rheingoldheavy/arduino_uno_r3_from_scratch/(threads)

Thread 2 (2018-07-18):

KiCad library remap

hildogjr, 2018-07-18:
Is not possible to open the project and when opened doesn't recognize the libraries. This problem is caused by KiCad library migration.
Check discussion on https://forum.kicad.info/t/important-symbol-library-table-merged-into-development-branch/8447/17 that help to make a manual migration, if necessary.

Thread 4 (2023-01-27):

RESET circuit is wrong

DeepCoreSystem, 2023-01-27:
The RESET circuit on your schematic is wrong when compared to the Atmel AppNote AVR042. In normal operation, you have 5V - 0.7V = 4.3V at the RESET pin, but it doesn't provide any over-voltage protection. And when pushing the reset switch, you will have a short circuit to ground from 5V_LDO through D7 and the switch, without any resistance.
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

This picture below is copied directly from the AppNote AVR042 - AVR Hardware Design Considerations
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

sabogalc, 2024-04-29:
This was also mentioned in PR #1
