rheingoldheavy/arduino_uno_r3_from_scratch/ATMEGA16U2.sch

## KiCad design ATMEGA16U2.sch (2021-08-06)

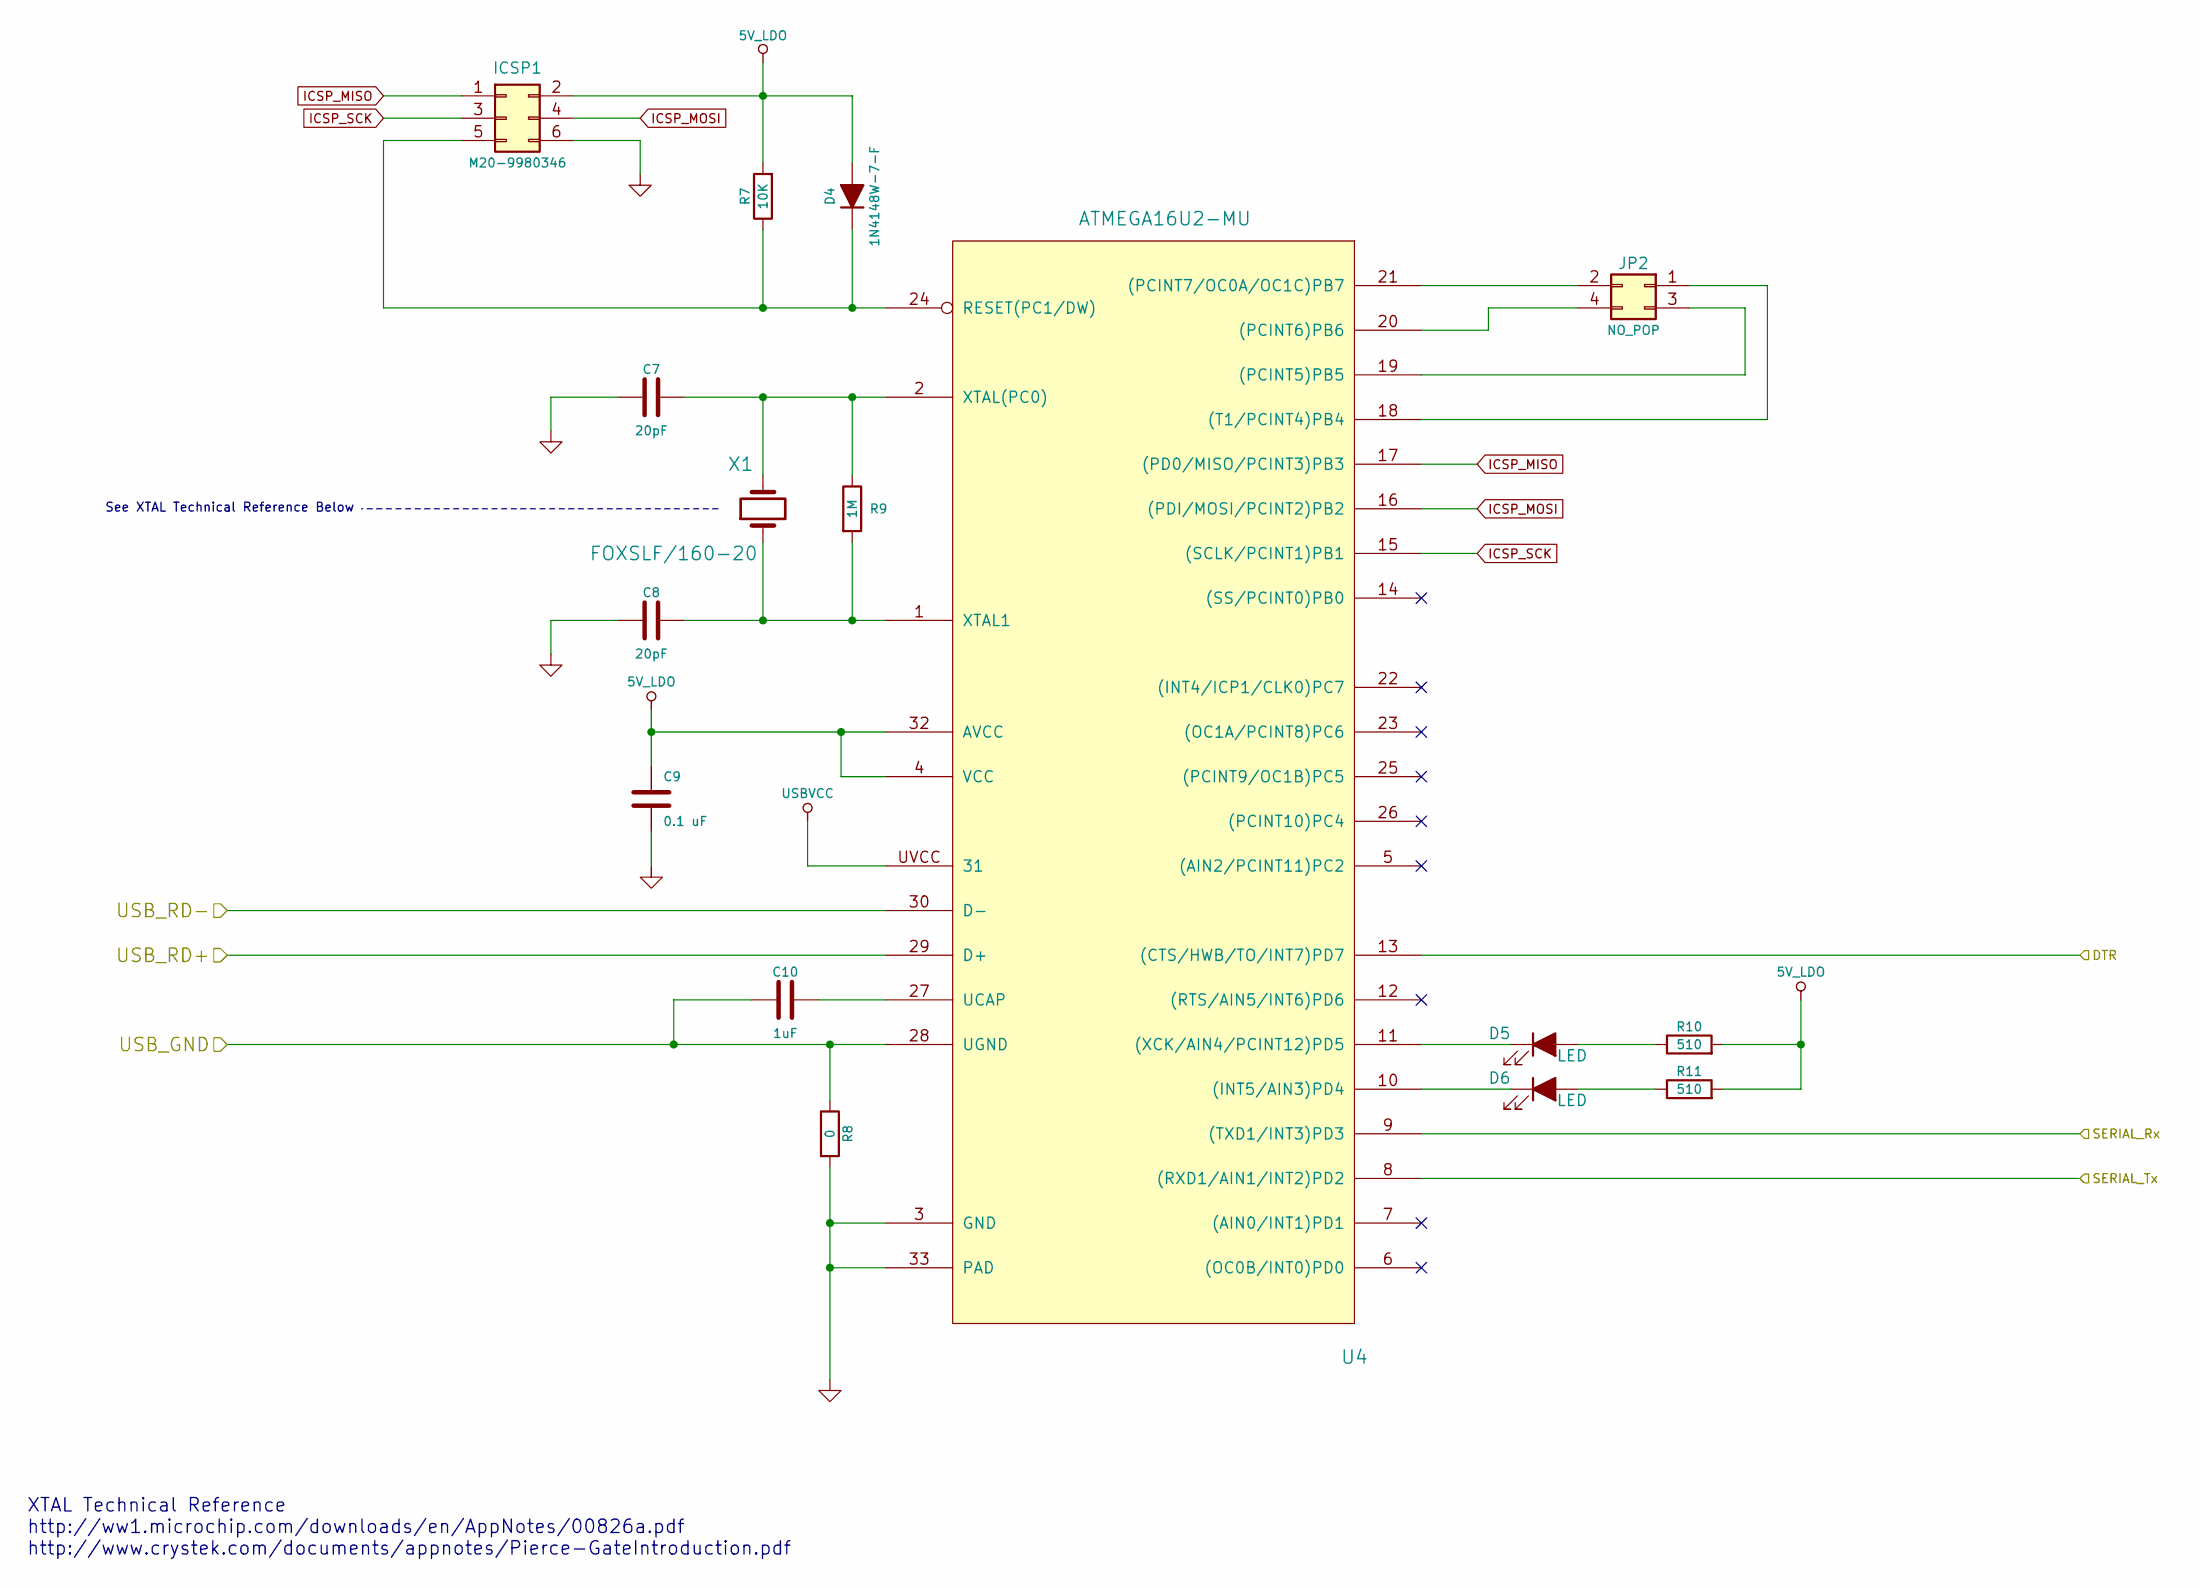
[picture p1: schematic ATMEGA16U2.sch]

Parts:
C7, C8: 20pF; MPN C0805C200G5GACTU
C9: 0.1 uF; MPN C0805C104K1RACAUTO
C10: 1uF; MPN C0805C105K8RACAUTO
D4: 1N4148W-7-F; MPN 1N4148W-7-F
D5, D6: LED; MPN LG R971-KN-1
ICSP1: M20-9980346; MPN M20-9980346
JP2: NO_POP; MPN FOOTPRINT ONLY
R7: 10K; MPN CRCW080510K0JNEA
R8: 0; MPN ERJ-6GEY0R00V
R9: 1M; MPN CRCW08051M00FKEA
R10, R11: 510; MPN RC0805FR-07510RL
U4: ATMEGA16U2-MU; MPN ATMEGA16U2-MU
X1: FOXSLF/160-20; MPN FOXSLF/160-20

Connections:
5V_LDO: C9.1, D4.2 (A), ICSP1.2, R7.2, R10.2, R11.2, U4.4 (VCC), U4.32 (AVCC)
DTR: U4.13 ((CTS/HWB/TO/INT7)PD7)
GND: C7.1, C8.1, C9.2, ICSP1.6, R8.2, U4.3 (GND), U4.33 (PAD)
ICSP_MISO: ICSP1.1, U4.17 ((PD0/MISO/PCINT3)PB3)
ICSP_MOSI: ICSP1.4, U4.16 ((PDI/MOSI/PCINT2)PB2)
ICSP_SCK: ICSP1.3, U4.15 ((SCLK/PCINT1)PB1)
unnamed: C7.2, R9.1, U4.2 (XTAL(PC0)), X1.2
unnamed: C8.2, R9.2, U4.1 (XTAL1), X1.1
unnamed: C10.2, U4.27 (UCAP)
unnamed: D4.1 (K), ICSP1.5, R7.1, U4.24 (RESET(PC1/DW))
unnamed: D5.1 (K), U4.11 ((XCK/AIN4/PCINT12)PD5)
unnamed: D5.2 (A), R10.1
unnamed: D6.1 (K), U4.10 ((INT5/AIN3)PD4)
unnamed: D6.2 (A), R11.1
unnamed: JP2.1, U4.18 ((T1/PCINT4)PB4)
unnamed: JP2.2, U4.21 ((PCINT7/OC0A/OC1C)PB7)
unnamed: JP2.3, U4.19 ((PCINT5)PB5)
unnamed: JP2.4, U4.20 ((PCINT6)PB6)
SERIAL_Rx: U4.9 ((TXD1/INT3)PD3)
SERIAL_Tx: U4.8 ((RXD1/AIN1/INT2)PD2)
USBVCC: U4.UVCC (31)
USB_GND: C10.1, R8.1, U4.28 (UGND)
USB_RD+: U4.29 (D+)
USB_RD-: U4.30 (D-)

Notes on the sheet:
XTAL Technical Reference http://ww1.microchip.com/downloads/en/AppNotes/00826a.pdf http://www.crystek.com/documents/appnotes/Pierce-GateIntroduction.pdf
See XTAL Technical Reference Below
