rheingoldheavy/arduino_uno_r3_from_scratch/ATMEGA328P.sch

## KiCad design ATMEGA328P.sch (2021-08-06)

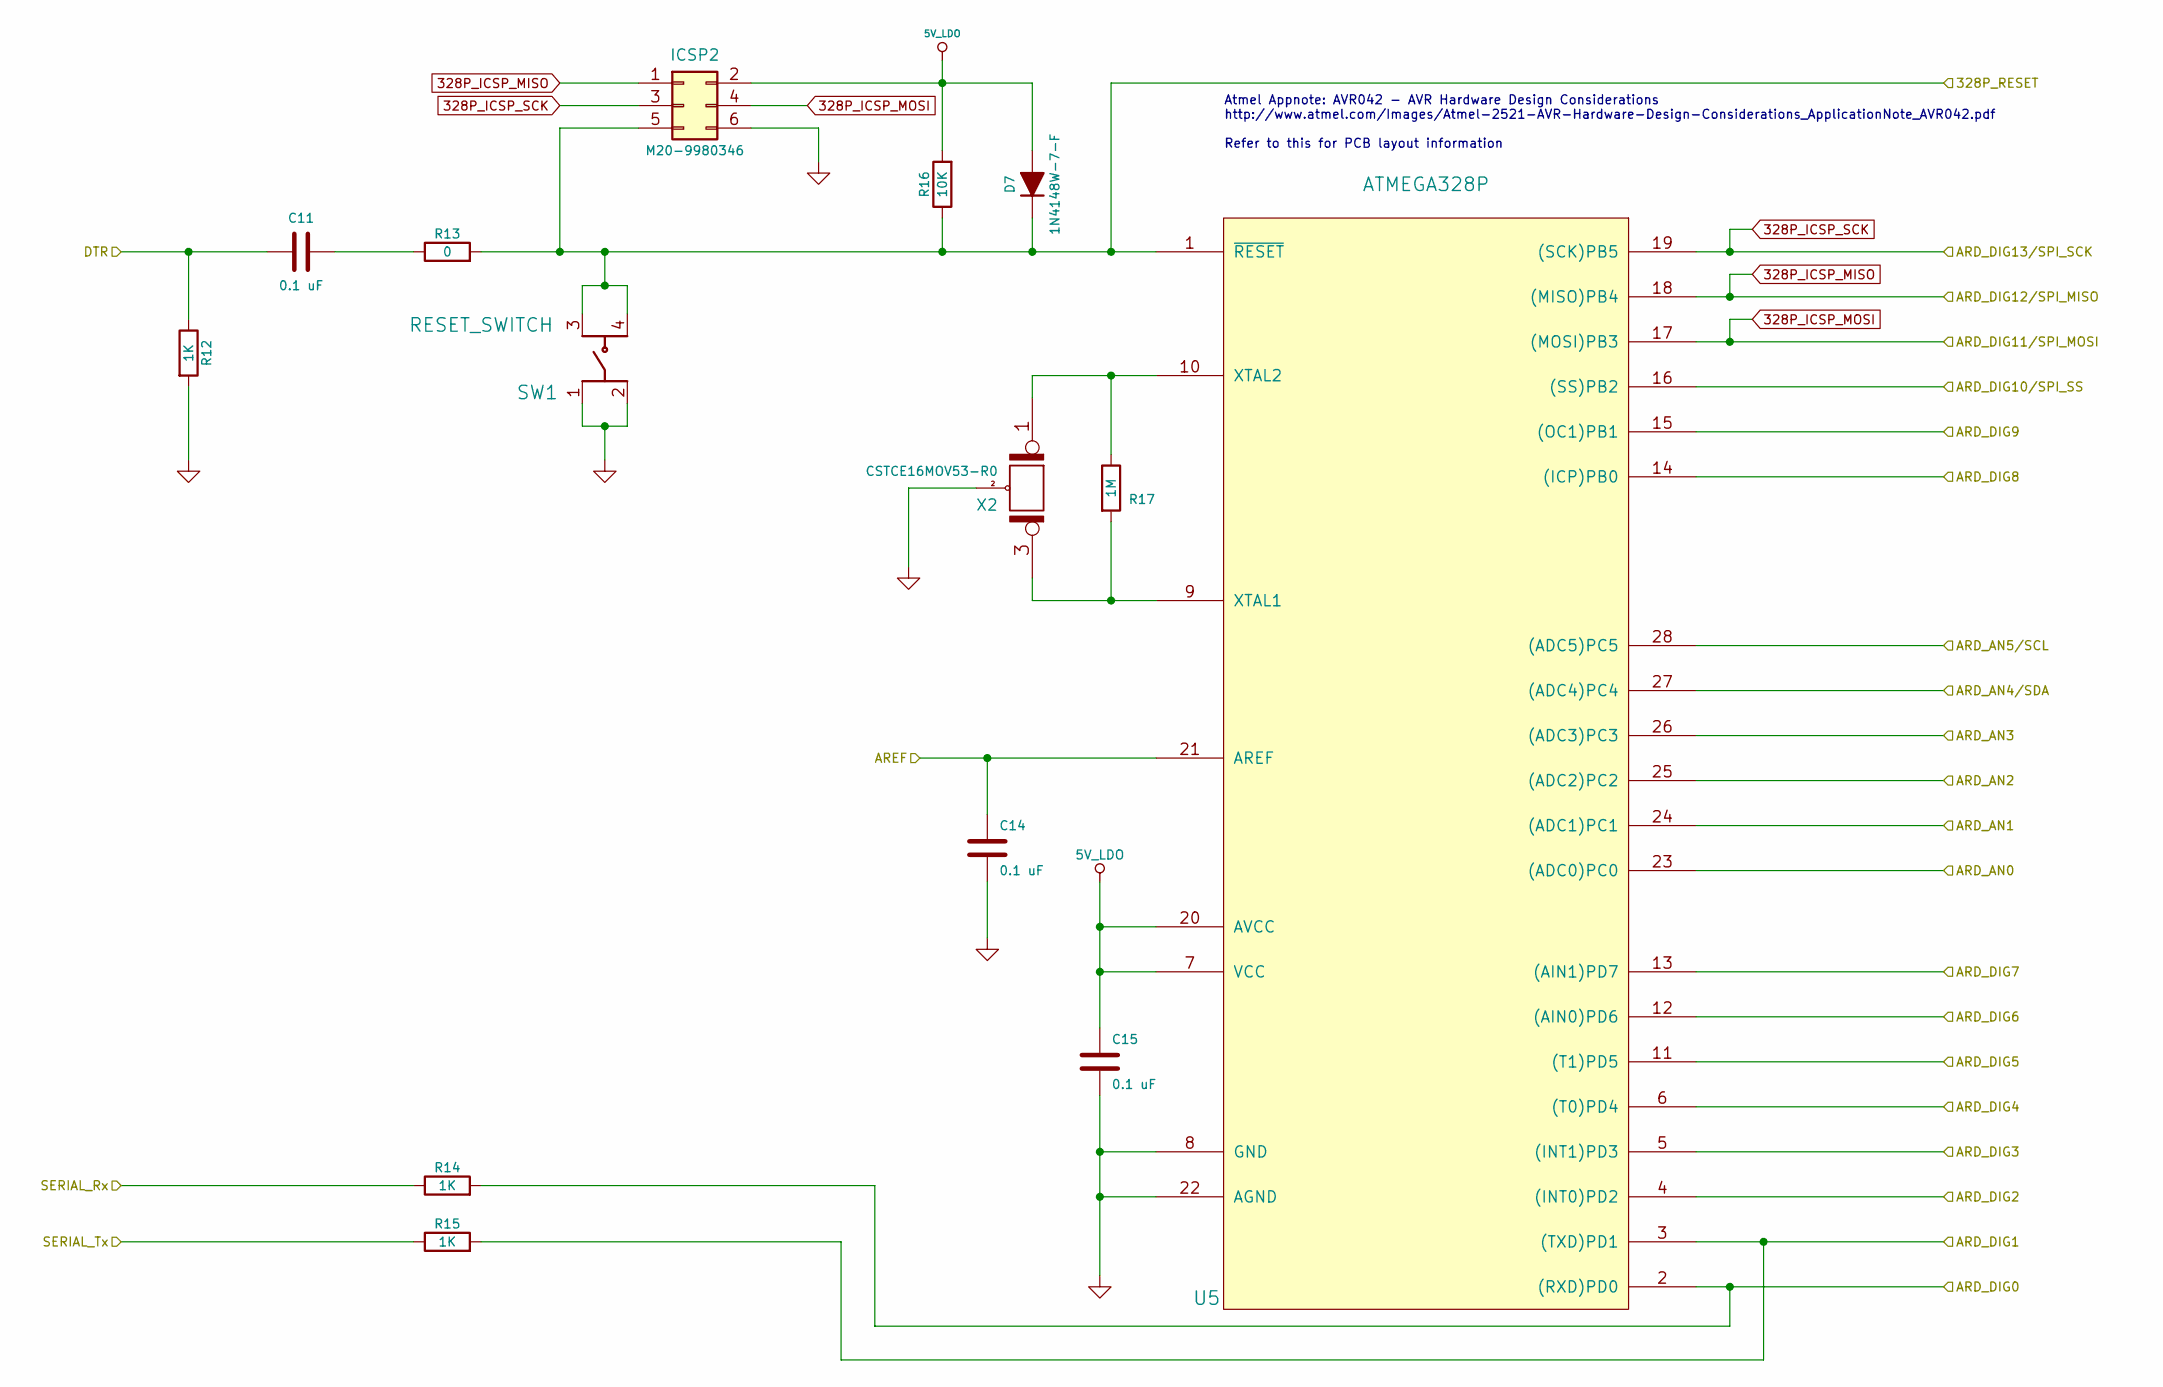
[picture p2: schematic ATMEGA328P.sch]

Parts:
C11, C14, C15: 0.1 uF; MPN C0805C104K1RACAUTO
D7: 1N4148W-7-F; MPN 1N4148W-7-F
ICSP2: M20-9980346; MPN M20-9980346
R12, R14, R15: 1K; MPN CRCW08051K00JNEA
R13: 0; MPN ERJ-6GEY0R00V
R16: 10K; MPN CRCW080510K0JNEA
R17: 1M; MPN CRCW08051M00FKEA
SW1: RESET_SWITCH; MPN EVQ-Q2U02W
U5: ATMEGA328P; MPN ATMEGA328P-PU
X2: CSTCE16MOV53-R0; MPN CSTCE16M0V53-R0

Connections:
5V_LDO: C15.1, D7.2 (A), ICSP2.2, R16.2, U5.7 (VCC), U5.20 (AVCC)
328P_ICSP_MISO: ICSP2.1, U5.18 ((MISO)PB4)
328P_ICSP_MOSI: ICSP2.4, U5.17 ((MOSI)PB3)
328P_ICSP_SCK: ICSP2.3, U5.19 ((SCK)PB5)
328P_RESET: D7.1 (K), ICSP2.5, R13.2, R16.1, SW1.3, SW1.4, U5.1 (~RESET)
ARD_AN0: U5.23 ((ADC0)PC0)
ARD_AN1: U5.24 ((ADC1)PC1)
ARD_AN2: U5.25 ((ADC2)PC2)
ARD_AN3: U5.26 ((ADC3)PC3)
ARD_AN4/SDA: U5.27 ((ADC4)PC4)
ARD_AN5/SCL: U5.28 ((ADC5)PC5)
ARD_DIG0: R14.2, U5.2 ((RXD)PD0)
ARD_DIG1: R15.2, U5.3 ((TXD)PD1)
ARD_DIG2: U5.4 ((INT0)PD2)
ARD_DIG3: U5.5 ((INT1)PD3)
ARD_DIG4: U5.6 ((T0)PD4)
ARD_DIG5: U5.11 ((T1)PD5)
ARD_DIG6: U5.12 ((AIN0)PD6)
ARD_DIG7: U5.13 ((AIN1)PD7)
ARD_DIG8: U5.14 ((ICP)PB0)
ARD_DIG9: U5.15 ((OC1)PB1)
ARD_DIG10/SPI_SS: U5.16 ((SS)PB2)
AREF: C14.1, U5.21 (AREF)
DTR: C11.1, R12.1
GND: C14.2, C15.2, ICSP2.6, R12.2, SW1.1, SW1.2, U5.8 (GND), U5.22 (AGND), X2.2 (PM)
unnamed: C11.2, R13.1
unnamed: R17.1, U5.10 (XTAL2), X2.1
unnamed: R17.2, U5.9 (XTAL1), X2.3
SERIAL_Rx: R14.1
SERIAL_Tx: R15.1

Notes on the sheet:
Atmel Appnote: AVR042 - AVR Hardware Design Considerations http://www.atmel.com/Images/Atmel-2521-AVR-Hardware-Design-Considerations_ApplicationNote_AVR042.pdf Refer to this for PCB layout information
