rheingoldheavy/arduino_uno_r3_from_scratch/Headers.sch

## KiCad design Headers.sch (2021-08-06)

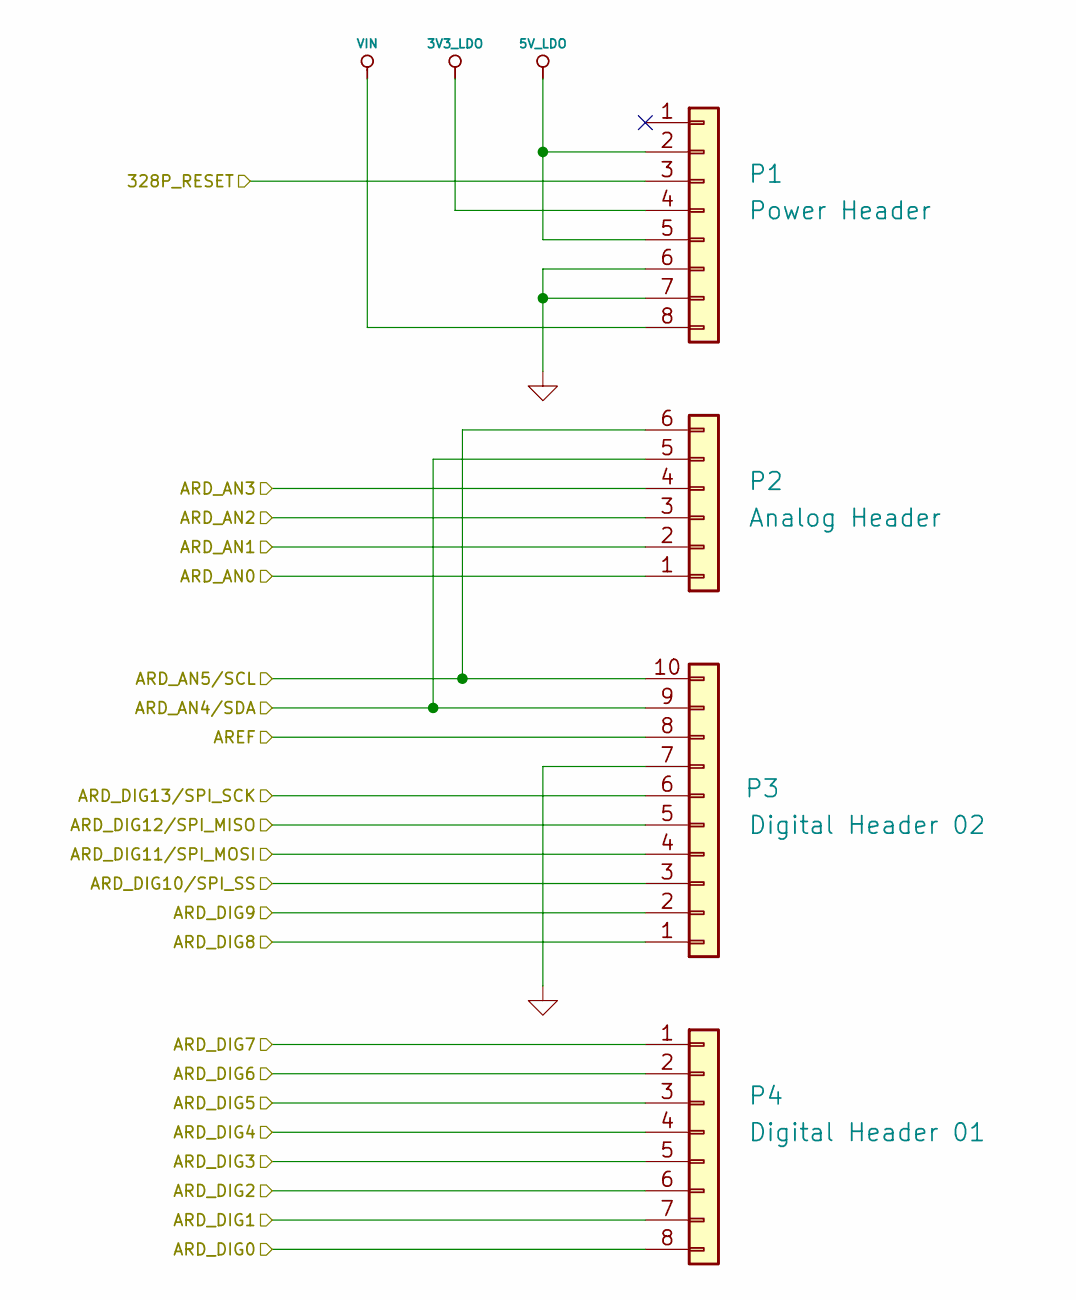
[picture p3: schematic Headers.sch]

Parts:
P1: Power Header; MPN NPPC081KFXC-RC
P2: Analog Header; MPN NPPC061KFXC-RC
P3: Digital Header 02; MPN NPPC101KFXC-RC
P4: Digital Header 01; MPN NPPC081KFXC-RC

Connections:
3V3_LDO: P1.4
5V_LDO: P1.2, P1.5
328P_RESET: P1.3
ARD_AN0: P2.1
ARD_AN1: P2.2
ARD_AN2: P2.3
ARD_AN3: P2.4
ARD_AN4/SDA: P2.5, P3.9
ARD_AN5/SCL: P2.6, P3.10
ARD_DIG0: P4.8
ARD_DIG1: P4.7
ARD_DIG2: P4.6
ARD_DIG3: P4.5
ARD_DIG4: P4.4
ARD_DIG5: P4.3
ARD_DIG6: P4.2
ARD_DIG7: P4.1
ARD_DIG8: P3.1
ARD_DIG9: P3.2
ARD_DIG10/SPI_SS: P3.3
ARD_DIG11/SPI_MOSI: P3.4
ARD_DIG12/SPI_MISO: P3.5
ARD_DIG13/SPI_SCK: P3.6
AREF: P3.8
GND: P1.6, P1.7, P3.7
VIN: P1.8
