rheingoldheavy/arduino_uno_r3_from_scratch/Pin_13_LED.sch

## KiCad design Pin_13_LED.sch (2021-08-06)

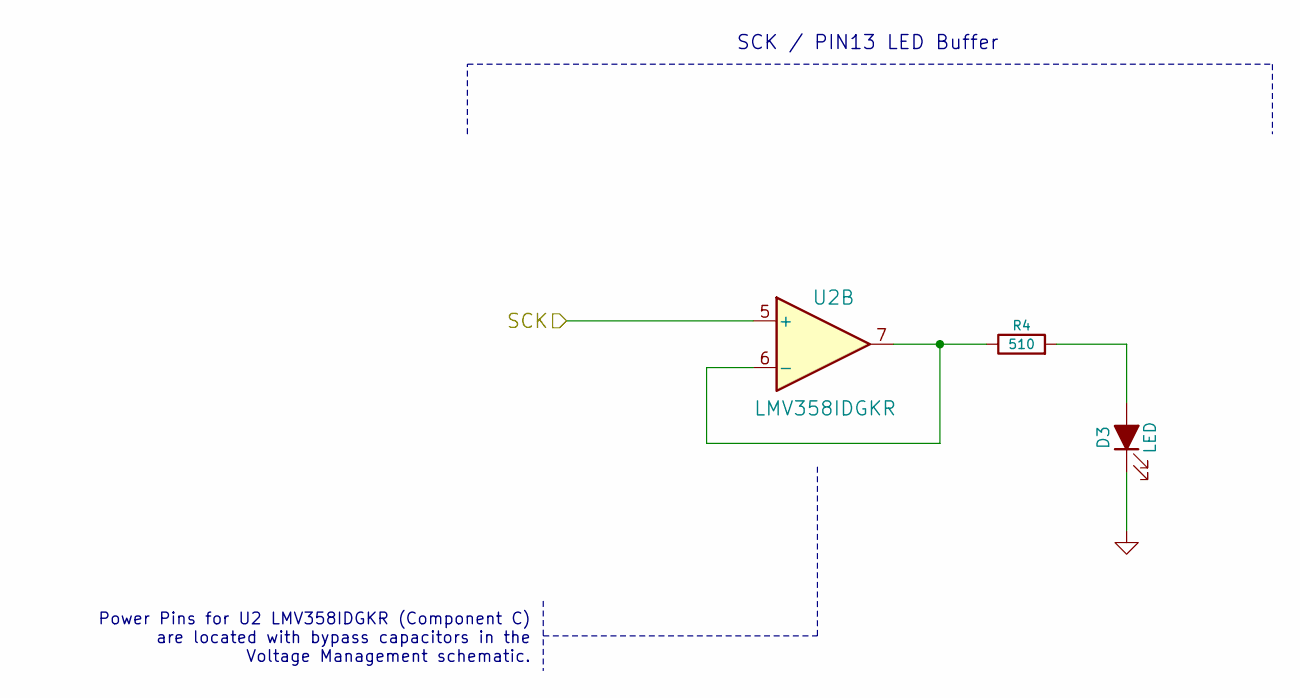
[picture p4: schematic Pin_13_LED.sch]

Parts:
D3: LED; MPN LG R971-KN-1
R4: 510; MPN RC0805FR-07510RL
U2: LMV358IDGKR; MPN LMV358IDGKR

Connections:
GND: D3.1 (K)
unnamed: D3.2 (A), R4.2
unnamed: R4.1, U2.6 (-), U2.7
SCK: U2.5 (+)

Notes on the sheet:
SCK / PIN13 LED Buffer
Power Pins for U2 LMV358IDGKR (Component C) are located with bypass capacitors in the Voltage Management schematic.
