rheingoldheavy/arduino_uno_r3_from_scratch/USB_Interface.sch

## KiCad design USB_Interface.sch (2021-08-06)

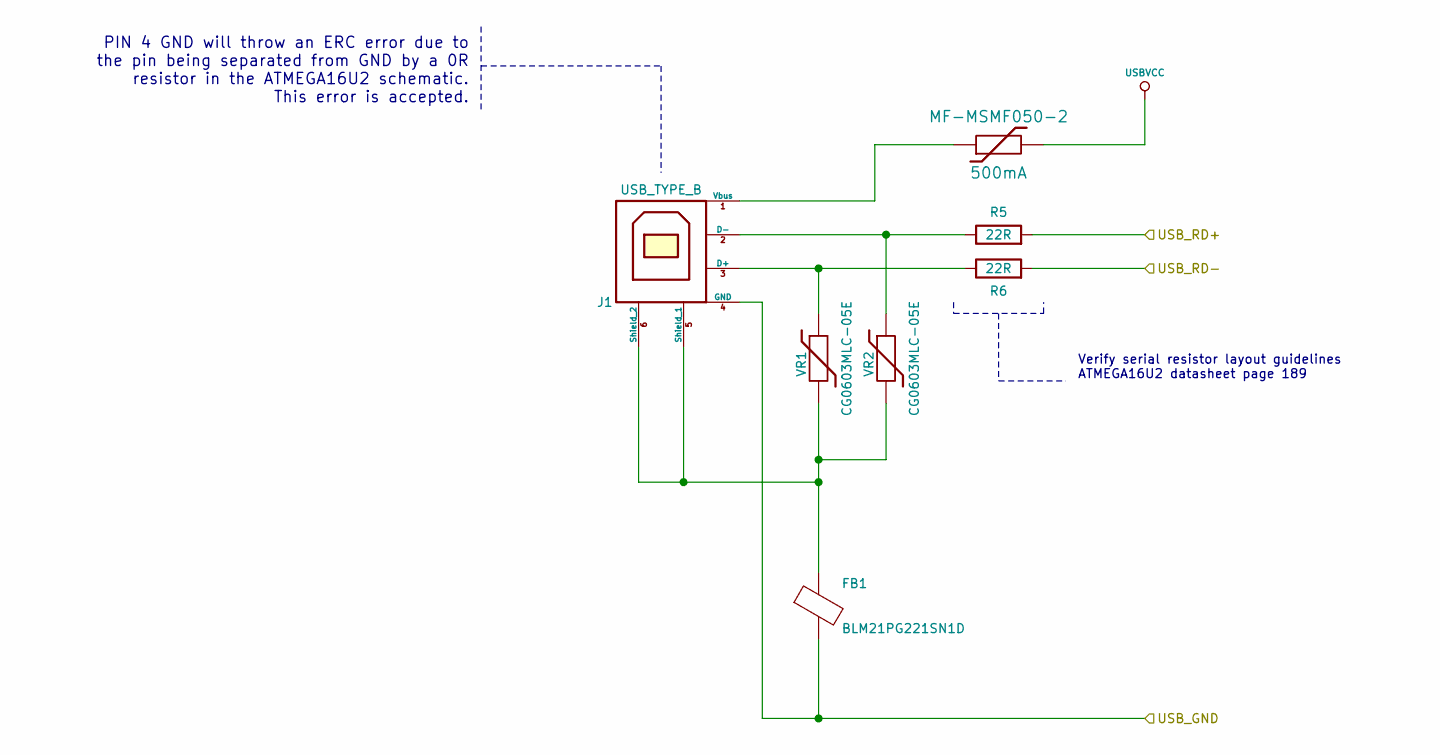
[picture p5: schematic USB_Interface.sch]

Parts:
FB1: BLM21PG221SN1D; MPN BLM21PG221SN1D
J1: USB_TYPE_B; MPN 292304-1
MF-MSMF050-2: 500mA; MPN MF-MSMF050-2
R5, R6: 22R; MPN RC0805JR-0722RL
VR1, VR2: CG0603MLC-05E; MPN CG0603MLC-05E

Connections:
unnamed: FB1.1, J1.5 (Shield_1), J1.6 (Shield_2), VR1.2, VR2.2
unnamed: J1.1 (Vbus), MF-MSMF050-2.1
unnamed: J1.2 (D-), R5.1, VR2.1
unnamed: J1.3 (D+), R6.1, VR1.1
USBVCC: MF-MSMF050-2.2
USB_GND: FB1.2, J1.4 (GND)
USB_RD+: R5.2
USB_RD-: R6.2

Notes on the sheet:
Verify serial resistor layout guidelines ATMEGA16U2 datasheet page 189
PIN 4 GND will throw an ERC error due to the pin being separated from GND by a 0R resistor in the ATMEGA16U2 schematic. This error is accepted.
