rheingoldheavy/arduino_uno_r3_from_scratch/Voltage_Regulator.sch

## KiCad design Voltage_Regulator.sch (2021-08-06)

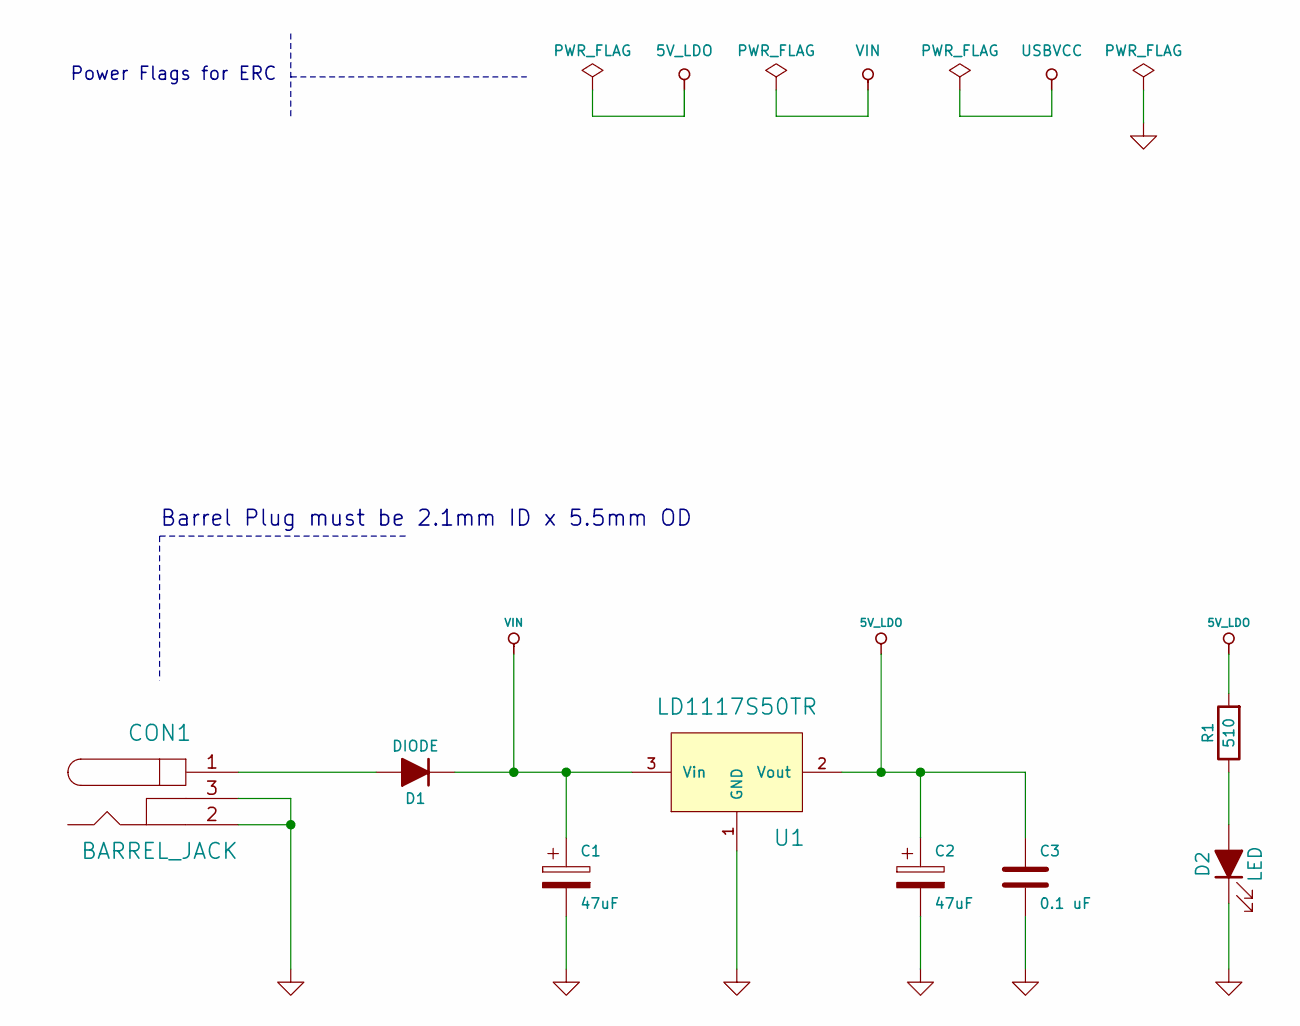
[picture p6: schematic Voltage_Regulator.sch]

Parts:
C1, C2: 47uF; MPN MAL215371479E3
C3: 0.1 uF; MPN C0805C104K1RACAUTO
CON1: BARREL_JACK; MPN 694106106102
D1: DIODE; MPN MRA4007T3G
D2: LED; MPN LG R971-KN-1
R1: 510; MPN RC0805FR-07510RL
U1: LD1117S50TR; MPN LD1117S50TR

Connections:
5V_LDO: C2.1, C3.1, R1.2, U1.2 (Vout)
GND: C1.2, C2.2, C3.2, CON1.2, CON1.3, D2.1 (K), U1.1 (GND)
unnamed: CON1.1, D1.2 (A)
unnamed: D2.2 (A), R1.1
VIN: C1.1, D1.1 (K), U1.3 (Vin)

Notes on the sheet:
Barrel Plug must be 2.1mm ID x 5.5mm OD
Power Flags for ERC
