rheingoldheavy/arduino_uno_r3_from_scratch/voltage_management.sch

## KiCad design voltage_management.sch (2021-08-06)

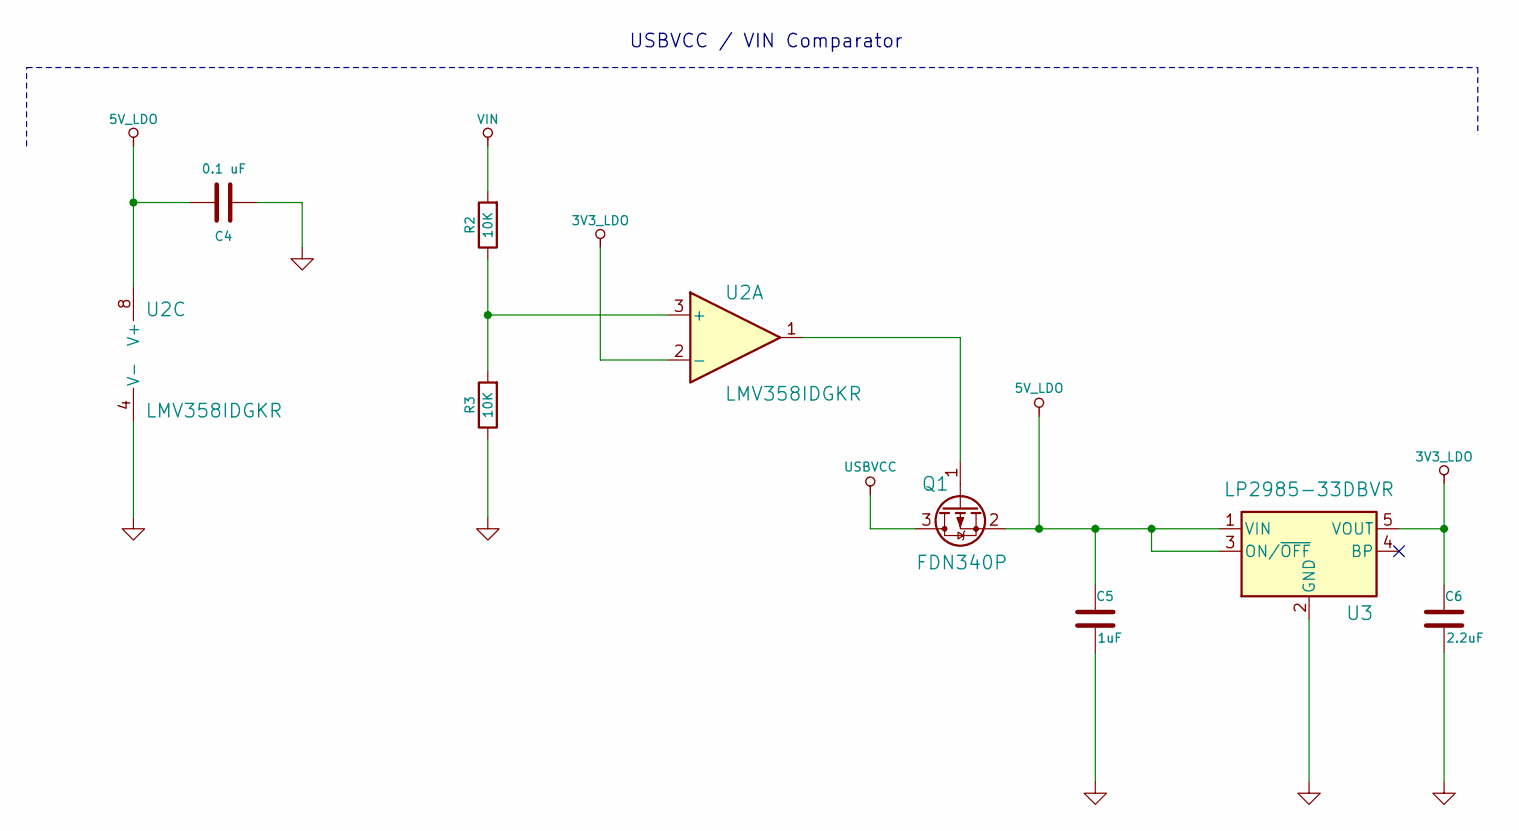
[picture p7: schematic voltage_management.sch]

Parts:
C4: 0.1 uF; MPN C0805C104K1RACAUTO
C5: 1uF; MPN C0805C105K8RACAUTO
C6: 2.2uF; MPN C2012X7R1C225K125AB
Q1: FDN340P; MPN FDN340P
R2, R3: 10K; MPN CRCW080510K0JNEA
U2: LMV358IDGKR; MPN LMV358IDGKR
U3: LP2985-33DBVR; MPN LP2985-33DBVR

Connections:
3V3_LDO: C6.1, U2.2 (-), U3.5 (VOUT)
5V_LDO: C4.2, C5.1, Q1.2 (S), U2.8 (V+), U3.1 (VIN), U3.3 (ON/~OFF~)
GND: C4.1, C5.2, C6.2, R3.1, U2.4 (V-), U3.2 (GND)
unnamed: Q1.1 (G), U2.1
unnamed: R2.1, R3.2, U2.3 (+)
USBVCC: Q1.3 (D)
VIN: R2.2

Notes on the sheet:
USBVCC / VIN Comparator
