rheingoldheavy/arduino_uno_r3_from_scratch/(commit log)

2015-10-19 Complete Arduino UNO R3 Schematic and BOM
    [ATMEGA16U2.sch, ATMEGA328P.sch, Arduino_Uno_R3_From_Scratch.sch, Headers.sch, Pin_13_LED.sch, USB_Interface.sch, Voltage_Regulator.sch, voltage_management.sch]
2021-08-06 REV1 Schematic Update
    Full schematic revised for compatibility with KiCad v5. All symbols should load from correct libraries, either project associated to a locally included library or to KiCad Default Libraries.
    All "rescue" libraries and references cleaned and / or removed.
    Manufacturers Part Number "MFP" field name modified to standard "MPN".
    Barrel Jack corrected to be center positive. (h/t Brett who wrote to tell me that).
    New BOM CSV file generated.
    [ATMEGA16U2.sch, ATMEGA328P.sch, Arduino_Uno_R3_From_Scratch.csv, Arduino_Uno_R3_From_Scratch.sch, Headers.sch, Pin_13_LED.sch, USB_Interface.sch, Voltage_Regulator.sch]
